RafDuch/wp2-rover/Final/doc_ref_mathworks/MW_MakerFaire_Paris_Robot_BOM.xlsx

Sheet: Sheet1
Maker Faire Paris Robot Competition Hardware BOM
Per Robot BOM
Quantity | Description | Part Number | Price TTC EUR | Price | Source 1 | Source 2 | Price | Volume Price
2 | Motors with encoders | PMT1-19 | 19.2 | 38.4 | http://www.lextronic.fr/P5448-moteur-reducteur-avec-encodeur.html
1 | 3D Printed parts kit | see below | 0 | 0 | custom
1 | Screw kit | TBD | 5 | 5
1 | Camera tube mount |  | 1 | 1 | pvc tube 20mm dia
1 | Caster wheel |  | 2.5 | 2.5 | http://www.gotronic.fr/art-roue-metallique-ow006-17750.htm | http://radiospares-fr.rs-online.com/web/p/billes-porteuses/0687635/
1 | DF Robot 2A Motor Shield |  | 15 | 15 | http://www.gotronic.fr/art-shield-motor-dri0009-2-x-2-a-19345.htm
2 | Toggle switch |  | 1.56 | 3.12 | http://www.lextronic.fr/P5552-interrupteur-a-levier-miniature-on-on.html
2 | Pushbutton |  | 2.22 | 4.44 | http://www.lextronic.fr/P5418-bouton-poussoir-digitast-bleu.html
1 | 5V regulator | TI PTH08080 | 6 | 6 | b
1 | LiPo Battery 2S 5400 mAH | Zippy Flightmax | 23.29 | 23.29 | http://www.hobbyking.com/hobbyking/store/uh_viewItem.asp?idProduct=38341
2 | Motor connector |  | 0.29 | 0.58 | http://radiospares-fr.rs-online.com/web/p/embases-de-circuit-imprime/5468912/ | http://www.digikey.com/product-detail/en/B6B-PH-K-S(LF)(SN)/455-1708-ND/926615
 | TOTAL |  |  | 98.33
1 | Wheel Pair | PMT-RR | 12 | 12 | http://www.lextronic.fr/P5450-paire-de-roue-pour-moteur-65-mm.html
1 | Motor mounts | PMT_SMM | 4.97 | 4.97 | http://www.lextronic.fr/P5449-jeu-de-2-supports-pour-moteurs.html
1 | USB Webcam |  | 53.14 | 53.14 | http://www.amazon.fr/Microsoft-LifeCam-Cinema-Webcam-filaire/dp/B002J1G4K8 | http://www.inmac-wstore.com/produits/p2552424/microsoft-lifecam-cinema-for-business---webcam.htm
0 | Raspbery Pi camera |  | 28.5 | 0 | http://www.hobbyking.com/hobbyking/store/uh_viewItem.asp?idProduct=31693 | http://fr.rs-online.com/web/p/modules-videos/7757731/?origin=PSF_437599|acc
1 | Arduino DUE |  | 46.16 | 46.16 | http://www.amazon.fr/ARDUINO-A000062-Arduino-Due-Microcontr%C3%B4leur/dp/B00A6C3JN2
1 | Raspberry Pi 512MB |  | 35.89 | 35.89 | http://www.amazon.fr/Raspberry-Pi-RBCA000-Carte-1176JZF-S/dp/B008PT4GGC | http://fr.rs-online.com/web/p/kits-de-developpement-pour-processeurs-et-microcontroleurs/7858654/
1 | SD Card 4GB |  | 6 | 6
 | TOTAL |  |  | 256.49
3D Printed parts kit
Quantity | Description
1 | Battery mount
1 | Raspberry Pi mount
1 | Arduino mount
2 | Motor Mount
1 | Switch Mount
2 | Wheels with hub and rubber band
1 | Camera mount
1 | Camera tube
 | Robot Pricing for quantity: | 10 | 10
 | Description | Cost
 | Shipping for various items | 100 | 100
 | PCB | 150 | 150
 | Robot BOM | 2564.9 | 983.3
 | TOTAL | 2814.9 | 1233.3
Items we currently already have in house
QTY | Description
5 | Raspberry Pi
2 | Arduino DUE
 | USB Webcam
2 | Motor Shield
4 | wifi dongle
4 | Motors
1 | Raspberry Pi Camera
10 | USB cameras
 | Order Now
 | Motor connectors
 | Caster wheel
 | raspi connector female socket 0.1" 2x4 2x5
 | arduino 1x8 male 0.1"
 | http://www.ebay.co.uk/itm/AlienSpec-CSI-DSI-Camera-Ribbon-Cable-5cm-10cm-15cm-20cm-30cm-for-Raspberry-Pi-/121051772597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

Sheet: Sheet2
Radiospares
QTY | Price each (EUR TTC) | Description | Link
20 | 0.264 | motor connector | http://radiospares-fr.rs-online.com/web/p/embases-de-circuit-imprime/5468912/
10 | 34 | Raspberry Pi 512MB | http://fr.rs-online.com/web/p/kits-de-developpement-pour-processeurs-et-microcontroleurs/7858654/
10 | 18.99 | Raspberry Pi Camera | http://fr.rs-online.com/web/p/modules-videos/7757731/?origin=PSF_437599|acc
10 | 3.6 | wheel | http://radiospares-fr.rs-online.com/web/p/billes-porteuses/0687635/
15 | 5.85 | power supply | http://radiospares-fr.rs-online.com/web/p/modules-dalimentation-dc-dc/6617948/
20 | 1.69 | 2x5 female header 0.1" | http://radiospares-fr.rs-online.com/web/p/fiches-femelles-pour-ci/7655657/
20 | 0.05 | 1% resistor | http://radiospares-fr.rs-online.com/web/p/resistances-traversantes/6834196/
5 | 0.238 | dual row breakaway header male 0.1" | http://radiospares-fr.rs-online.com/web/p/embases-de-circuit-imprime/3606465/
20 | 0.0425 | single row breakaway header male 0.1" | http://radiospares-fr.rs-online.com/web/p/embases-de-circuit-imprime/0156134/
25 | 0.746 | 100 uF Capacitor | http://radiospares-fr.rs-online.com/web/p/condensateurs-aluminium/5370613/
Lextronic
QTY | Price each (EUR TTC) | Description | Link
20 | 19.2 | Motor with Encoder | http://www.lextronic.fr/P5448-moteur-reducteur-avec-encodeur.html
20 | 2.22 | pushbutton | http://www.lextronic.fr/P5418-bouton-poussoir-digitast-bleu.html
20 | 1.56 | toggle switch | http://www.lextronic.fr/P5552-interrupteur-a-levier-miniature-on-on.html
20 | 12 | Wheels | http://www.lextronic.fr/P5450-paire-de-roue-pour-moteur-65-mm.html
gotronic
QTY | Price each (EUR TTC) | Description | Link
10 | 15 | Arduino Motor Shield | http://www.gotronic.fr/art-shield-motor-dri0009-2-x-2-a-19345.htm
