RafDuch/wp2-rover/Final/doc_ref_mathworks/Robot_Wiring_v1.pdf

1

# Designed in Eagle PCB

free from cadsoft

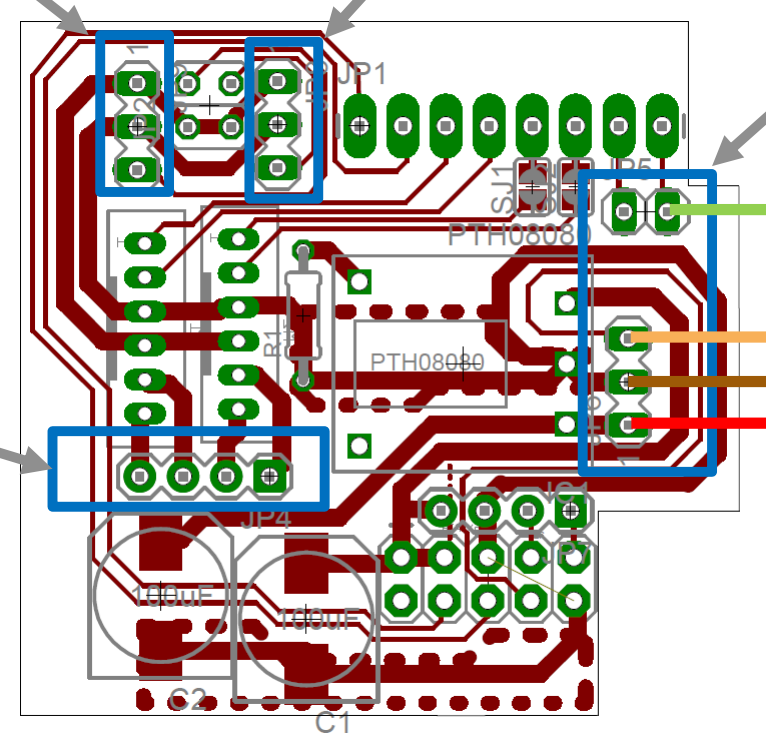
[picture p1: figure]

### To Motor Shield

### To Switches

RPI_GPIO
GND
BAT_IN

ARDUINO_GPIO

### To Servo To LED

Warning: GND and Power
reversed compared to
standard servo pintout

2

# PCB Schematics

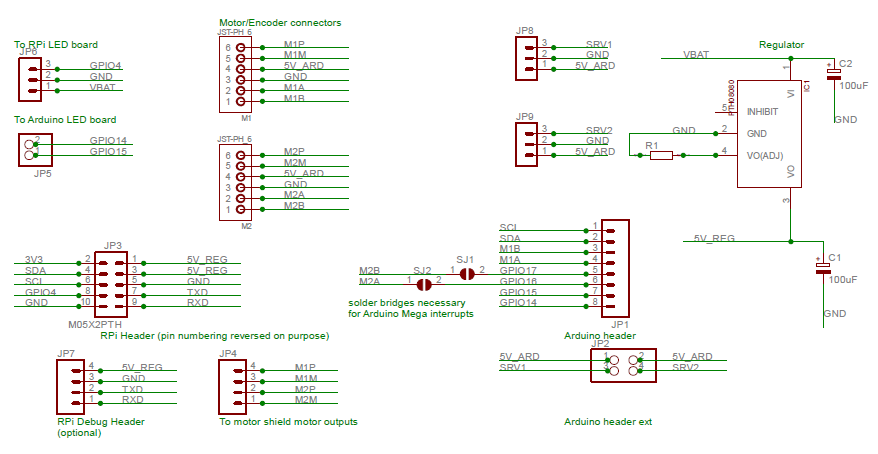
[picture p2: figure]

3

# Example wiring

### To PCB

### To switched BAT_IN

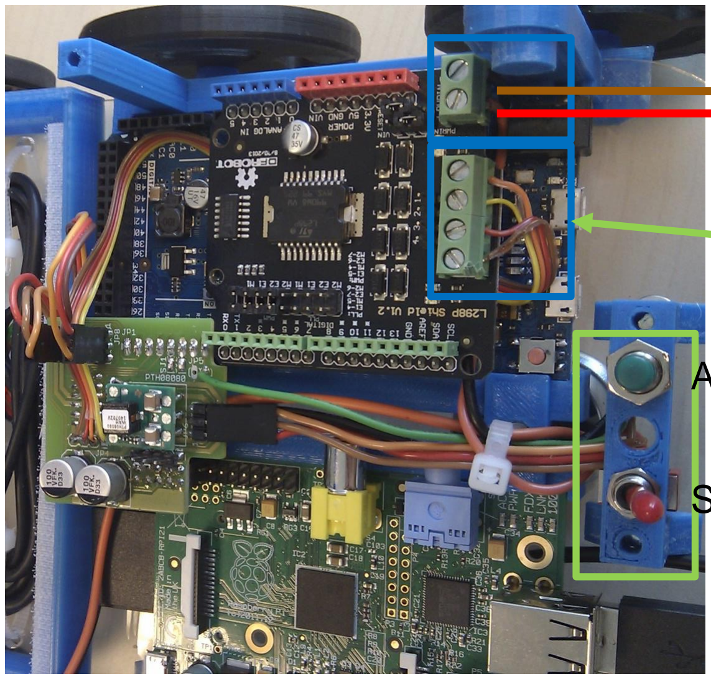
[picture p3: figure]

### Arduino pushbutton

### Switch on BAT_IN

In this picture the raspberry pi pushbutton is not present – that’s ok as it is not used in models (RPI_GPIO or GPIO4 on schematics)
