RafDuch/wp2-rover/(commit log)

2019-06-11 première version
    [MW_MakerFaire_Paris_Robot_BOM.xlsx, MW_MakerFaire_Paris_Robot_BOM_2.xlsx]
2019-06-11 ajout de couleurs
2019-06-11 ajout du fichier complet servo
2019-06-11 modif de detection couleur avec 0 autofocus
2019-06-12 passage en calsse de detection couleur + suivi de ligne
2019-06-12 modif du code servo
2019-06-12 remise du'ne version sans classe pour détection couleur + suivi de ligne
2019-06-12 code servo
2019-06-12 servo + progressif
2019-06-12 modification sur la partie arret d'urgence et servomoteur
2019-06-13 changement sur progressif niveau arduino
2019-06-13 servomoteur sur direction2
2019-06-13 coucou bebe 2
    [MW_MakerFaire_Paris_Robot_BOM.xlsx, MW_MakerFaire_Paris_Robot_BOM_2.xlsx]
2019-06-19 réarrangement des fichiers
    [MW_MakerFaire_Paris_Robot_BOM.xlsx, MW_MakerFaire_Paris_Robot_BOM_2.xlsx]
